coderkun12/Efficient-Keyword-Spotting-for-Edge-Devices/Device-Check/roofline.png

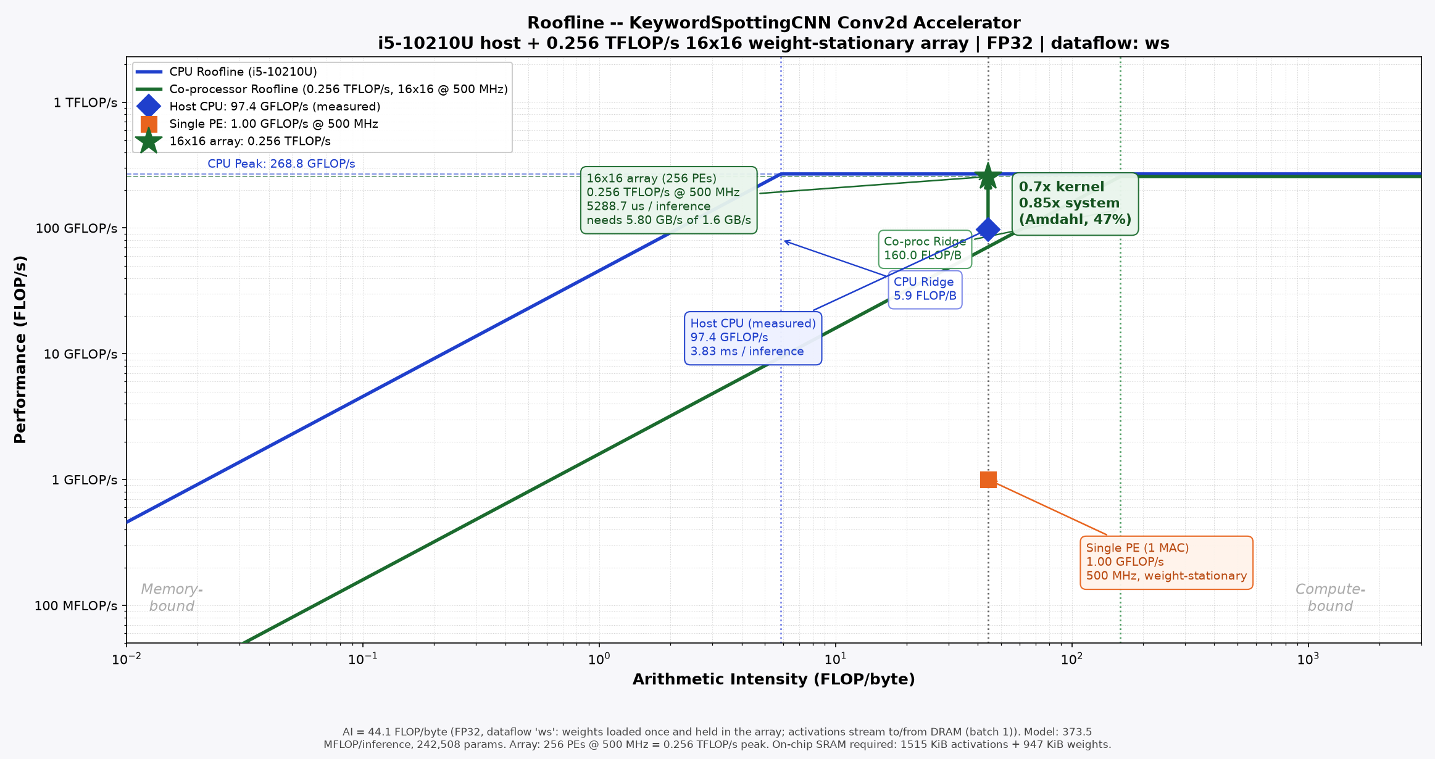
Device-Check/roofline.png
