coderkun12/Efficient-Keyword-Spotting-for-Edge-Devices/Profiling/roofline_chiplet.png

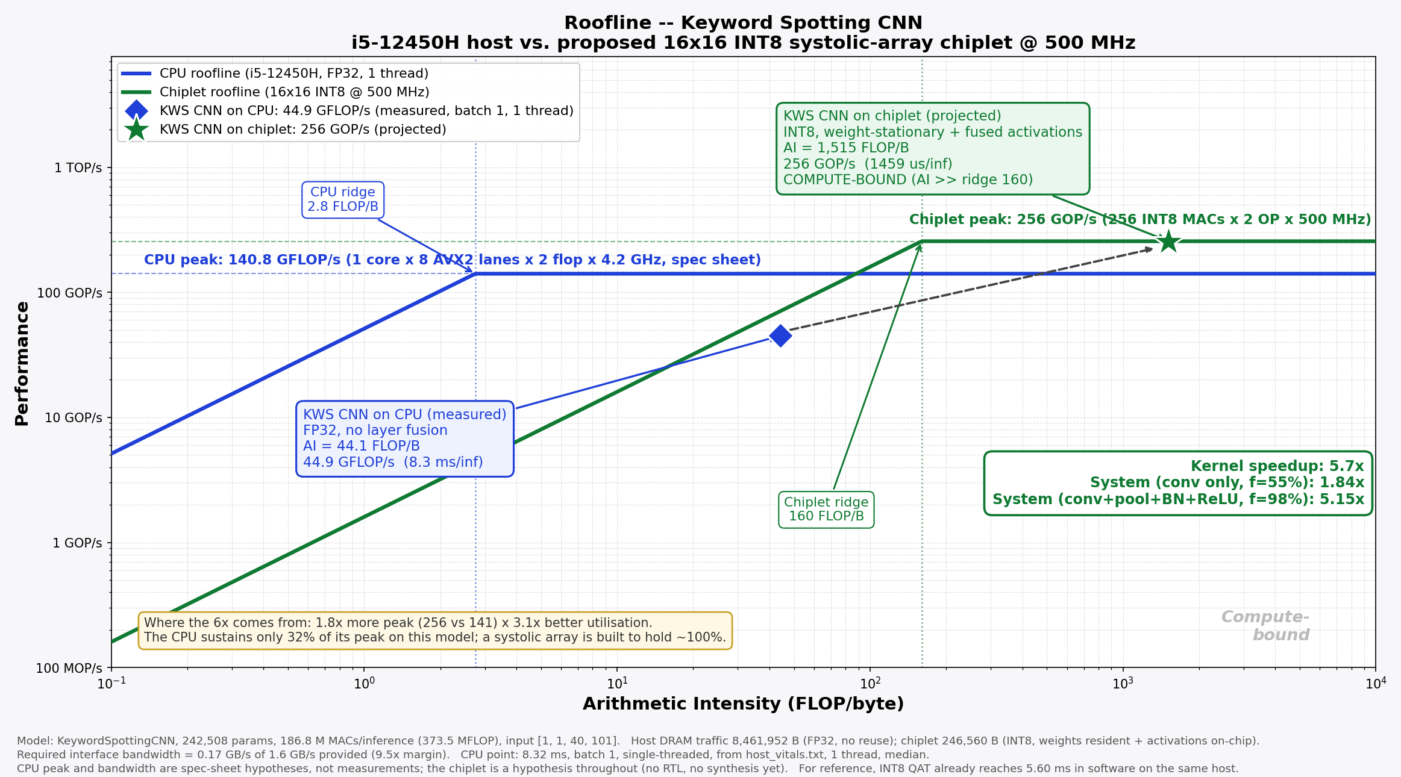
Profiling/roofline_chiplet.png
