coderkun12/Efficient-Keyword-Spotting-for-Edge-Devices/(commit log)

2026-09-24 Add FPGA validation, fix weight-commit skew, correct resource figures
    M5 (FPGA emulation) complete on a Terasic DE2i-150 (Cyclone IV GX
    EP4CGX150DF31C7). Two designs built, programmed and verified bit-exact:
    stage A/B mac_array alone, 64/64 outputs, 0 mismatches, ~69 MHz.
    Run with random INT8 and then with the trained conv2 tile.
    stage C full fused layer -- conv4 m-tile 0, 128->16 channels, W=25,
    H=10, 72 k-tiles accumulated, BatchNorm folded in, ReLU and
    2x2 max-pool fused. 60/60 outputs, 0 mismatches, ~51 MHz,
    33% logic / 15% memory / 44% multipliers.
    RTL FIX -- weight commit was skewed in one dimension, not two
    An activation re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
    [axis_result_fifo.sv, band_sram.sv, byte_ram.sv, de2i150_layer_top.sv, de2i150_mac_top.sv]
2026-09-24 Keep Device-Check as the single reference-host location
    The remote reorganisation already moved the LAPTOP-FFRP12TK profiling data
    into Device-Check/. This drops the parallel copy added under
    Profiling/reference_host/ -- byte-identical apart from line endings -- and
    keeps the provenance note, which the directory did not have.
    The note matters because Profiling/ holds the same four files regenerated on
    a different machine. Nothing marks them apart, and quoting one set alongside
    the other would move every Amdahl figure in the report with nothing looking
    wrong.
2026-09-25 Restore the Genus synthesis reports
    The File-Restructuring commit moved README.md, mac_array.sdc and the
    netlist into hardware/synthesis_mac_array_1GHz/ but deleted the eight
    .rpt files rather than moving them. They are the evidence behind every
    line of the PPA table in MILESTONE_REPORT.md:
    qor.rpt 1 GHz, +299.3 ps slack, TNS 0.0, 0 violating paths
    area.rpt 40,487 um^2 (0.0405 mm^2), 60,607 cells
    power.rpt 52.45 mW active, 17.46 uW leakage
    -> 512 GOP/s / 52.45 mW = 9.76 TOPS/W
    Recovered from 615bcd5 and verified byte-identical by hash. 145 KB
    total, of which timing.rpt is 135 KB.
    Also adds a .gitignore exception for this directory. The *.rpt rule
    written for m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
2026-09-25 Repair imports and paths broken by the directory restructure
    The move to hardware/ and software/ left several path assumptions
    pointing at directories that no longer exist. Each failure was silent.
    Test suite: the testbench imports were rewritten to the package path
    hardware.rtl.tb.ref_model, but cocotb puts the tb/ directory on
    sys.path, not the repo root, so every rewritten module raised
    ModuleNotFoundError before collection. 123 of 129 tests collected zero
    and reported FAIL. Reverted to bare "from ref_model import", which
    matches the sys.path.insert already present in each file and the one
    suite left untouched. Back to 129/129, lint clean.
    Profiling: all six scripts inserted REPO_ROOT/"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
    [gen_layer_vectors.py, gen_test_vectors.py]
